Kyaa-A/oxyfeeder/app/assets/OxyFeeder.png

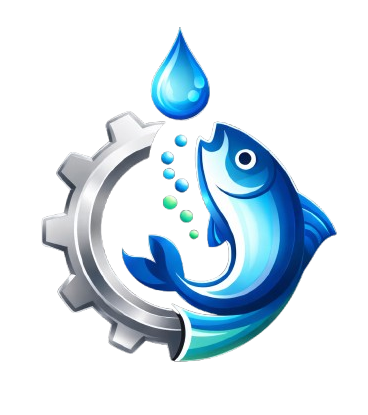
app/assets/OxyFeeder.png
