Kyaa-A/oxyfeeder/docs/session-log-jan24.md

# Development Session Log - January 24, 2026

## Session Summary

**Date:** January 24, 2026  
**Time:** 3:27 PM - 5:34 PM  
**Focus:** Phase 5 - Final Firmware Integration

---

## ✅ What Was Accomplished Today

### 1. Codebase Scan Complete
- Scanned entire project structure
- Reviewed all Flutter app code, firmware, and documentation
- Confirmed project is at ~95% completion

### 2. Phase 5 Firmware Written
- Created complete production firmware for Arduino Mega
- **File:** `firmware/oxyfeeder_firmware/oxyfeeder_firmware.ino` (787 lines)
- Features implemented:
  - Real sensor reading (DO sensor, voltage sensor, load cell)
  - RTC-based feeding schedule (08:00 and 17:00)
  - TFT LCD display with live data
  - Motor and servo control for feeding
  - Buzzer alarm for alerts
  - SMS alerts via SIM800L for critical low oxygen
  - JSON output to ESP32 via Serial1

### 3. ESP32 Firmware Uploaded Successfully ✅
- Uploaded `esp32_communicator.ino` to ESP32
- Verified ESP32 is advertising as "OxyFeeder" via BLE
- Confirmed working using nRF Connect app on phone

### 4. Configuration Updated
- Phone number for SMS alerts: `+639550717546`
- Feeding times: 08:00 and 17:00
- DO critical threshold: 4.0 mg/L

### 5. Cleaned Up Duplicate Files
- Moved `oxyfeeder_firmware_FINAL.ino` to backup (was causing compilation conflict)
- Moved `esp32_communicator_FINAL.ino` to backup

---

## ⏳ Blocked - Arduino Mega Driver Issue

### Problem:
- Arduino Mega not detected by PC
- Port shows "COM3 (not connected)"
- Cannot upload firmware to Arduino Mega

### Diagnosis:
- USB data cable works (confirmed with ESP32)
- Issue is likely:
  1. Arduino Mega uses CH340 chip (clone board) - needs driver
  2. OR Arduino Mega's USB port has hardware issue

### Solution Needed:
1. **Install CH340 driver:** https://sparks.gogo.co.nz/ch340.html
2. **OR** try different USB-B cable specifically for Arduino
3. **OR** test with a different Arduino Mega board

---

## 📋 Resume Checklist (Next Session)

When continuing, follow these steps:

```
[ ] 1. Fix Arduino Mega connection:
      - Install CH340 driver, OR
      - Try USB-B cable that works with other devices

[ ] 2. Upload firmware to Arduino Mega:
      - Open: firmware/oxyfeeder_firmware/oxyfeeder_firmware.ino
      - Board: Arduino Mega or Mega 2560
      - Port: (select detected COM port)
      - Click Upload

[ ] 3. Verify Arduino is working:
      - Open Serial Monitor (9600 baud)
      - Should see sensor readings and system status

[ ] 4. Connect Arduino to ESP32:
      - Arduino TX1 (pin 18) → Logic Shifter → ESP32 RX2 (pin 16)
      - Arduino RX1 (pin 19) → Logic Shifter → ESP32 TX2 (pin 17)
      - Power ESP32 from Arduino 5V

[ ] 5. Test end-to-end with phone:
      - Use nRF Connect to see real sensor data in JSON
      - OR run Flutter app on Android phone

[ ] 6. Phase 6: Field deployment and calibration
```

---

## 📁 Key File Locations

| File | Purpose |
|---|---|
| `firmware/oxyfeeder_firmware/oxyfeeder_firmware.ino` | Arduino Mega firmware (READY) |
| `firmware/esp32_communicator/esp32_communicator.ino` | ESP32 BLE bridge (UPLOADED ✅) |
| `app/lib/main.dart` | Flutter app entry point |
| `app/lib/core/services/real_bluetooth_service.dart` | Real BLE connection code |
| `docs/roadmap.md` | Project phases overview |

---

## 📊 Overall Project Status

| Phase | Description | Status |
|---|---|---|
| Phase 1 | Mobile App | ✅ Complete |
| Phase 2 | Communication Hub | ✅ Complete |
| Phase 3 | App Integration | ✅ Complete |
| Phase 4 | Hardware Assembly | ✅ Complete |
| Phase 5 | Final Firmware | 🔄 90% (Arduino upload pending) |
| Phase 6 | Deployment | ⏳ Next |

---

## 💡 Notes

- The Flutter app is currently set to **Mock Mode** for testing without hardware
- To switch to real hardware mode, edit `app/lib/main.dart` and swap the service providers
- ESP32 is ready and waiting for Arduino data
- All sensors and actuators are wired and ready

---

## 🆕 Late Addition: SMS Configuration Feature (5:50 PM)

### Feature Implemented
Added ability to configure SMS phone number from the app instead of hardcoding in firmware.

### Changes Made:

**1. Arduino Firmware (`oxyfeeder_firmware.ino`):**
- Added EEPROM library for persistent storage
- Phone number stored in EEPROM (survives power off)
- Added command processing from ESP32:
  - `PHONE:+639XXXXXXXXX` - Set phone number
  - `FEED:5` - Trigger manual feeding
  - `TEST_SMS:1` - Send test SMS
  - `GET_PHONE:1` - Get current phone number
- Default phone number: `+639550717546`

**2. ESP32 Firmware (`esp32_communicator.ino`):**
- Added WRITE characteristic for receiving commands from app
- New Command Characteristic UUID: `0000abcf-0000-1000-8000-00805f9b34fb`
- Commands from app are forwarded to Arduino via Serial2

**3. Flutter App (`real_bluetooth_service.dart`):**
- Added command characteristic discovery
- New methods:
  - `sendCommand(String command)` - Send raw command
  - `setPhoneNumber(String phone)` - Set SMS phone number
  - `triggerManualFeed()` - Trigger feeding
  - `sendTestSms()` - Send test SMS

**4. Settings Screen (`settings_screen.dart`):**
- Added "SMS Alert Configuration" section
- Phone number input field
- "Save to Device" button
- "Test SMS" button

**5. Settings ViewModel (`settings_viewmodel.dart`):**
- Added `smsPhoneNumber` property
- Added methods for sending commands via Bluetooth

### Data Flow for Commands:
```
App (Settings) → BLE Write → ESP32 → Serial2 → Arduino → EEPROM (save)
```

---

## ⚠️ ESP32 Needs Re-upload!

Since we updated the ESP32 firmware with the new command characteristic, you need to re-upload it when the Arduino driver is fixed.

---

**Next session focus:** Fix Arduino driver, re-upload ESP32, upload Arduino firmware, test full system!
