Kyaa-A/oxyfeeder/docs/create-prd.md

# Product Requirements Document: OxyFeeder

**Version:** 1.0  
**Date:** October 26, 2025  
**Author:** AI Product Manager  

---

## 1. Overview

OxyFeeder is an IoT-based, solar-powered aquaculture management system designed to automate critical fishpond operations. It provides automated, scheduled fish feeding and continuous, real-time monitoring of dissolved oxygen (DO) levels. The system is engineered for sustainability and resilience, making it ideal for small to medium-scale fish farms, particularly in remote or off-grid locations. By leveraging solar power and IoT connectivity, OxyFeeder aims to reduce manual labor, optimize feed usage, prevent fish kills from hypoxia, and promote data-driven, sustainable aquaculture.

---

## 2. Problem Statement

Traditional aquaculture practices are labor-intensive and prone to inefficiencies that impact profitability and sustainability. Key challenges include:

- **Manual Labor:** Daily manual feeding is time-consuming and inconsistent, leading to scheduling errors.  
- **Feed Waste:** Overfeeding wastes costly resources and contributes to water quality degradation. Underfeeding stunts fish growth.  
- **Hypoxia Risk:** Sudden drops in dissolved oxygen are a primary cause of mass fish kills. Manual spot-checks are often insufficient.  
- **Energy Costs:** Grid-powered systems are expensive and impractical for off-grid farms.  

OxyFeeder directly addresses these issues by providing an automated, self-powered, and intelligent monitoring solution.

---

## 3. Objectives

- Automate Core Operations  
- Enhance Water Quality Monitoring  
- Improve Resource Efficiency  
- Increase Accessibility  

---

## 4. Key Features

- Automated feeding based on schedule  
- Real-time DO monitoring  
- Multi-level alert system (App & SMS)  
- Solar-powered operation  
- OLED display for status  
- Optional ESP32-CAM camera monitoring  

---

## 5. Hardware & Software Components

**Hardware:** Arduino Mega 2560, ESP32, Solar System (Panel, MPPT, Battery), DC Gear Motor, DO Sensor, Load Cell, RTC, OLED, GSM, ESP32-CAM.  
**Software:** Custom Arduino/ESP32 firmware + Flutter mobile app.

---

## 6. User Stories

- As a fish farmer, I want to schedule feedings remotely.  
- As a fish farmer, I want alerts when DO or feed levels are low.  
- As a fish farmer, I want solar-powered autonomy for remote use.  
- As a fish farmer, I want to see feed level status in the app.  

---

## 7. Requirements

### Functional
- Automated feed dispensing on schedule  
- DO reading every 15 mins  
- Alerts for low DO, feed, or battery  
- App display for live data  

### Non-Functional
- 99% uptime  
- IP67 enclosure  
- 48h solar autonomy  
- Easy setup  
- Secure communication  

---

## 8. Success Metrics

- System uptime  
- Alert accuracy  
- Feed and power efficiency  
- User adoption rate  

---

## 9. Risks & Mitigation

| Risk | Likelihood | Impact | Mitigation |
|---|---|---|---|
| Hardware failure | Medium | High | Use waterproof, modular parts |
| Network loss | High | Medium | Fallback to GSM + local logging |
| Power failure | Low | High | MPPT + low-voltage cutoff |
| Sensor drift | Medium | Medium | Regular calibration schedule |

---

## 10. Future Enhancements

- Cloud dashboard for analytics  
- Add pH & temperature sensors  
- AI-based feeding prediction  
- Automatic aerator control
