Kyaa-A/oxyfeeder/(commit log)

2025-10-16 Restructure: move Flutter app into app/, add docs/ and firmware/; implement dashboard feature, SensorCard, and dark theme; add Sensors & Settings screens; create MainNavHost with BottomNavigationBar;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
2025-10-16 feat(settings): add AppSettings model, SettingsViewModel; wire MultiProvider; bind Settings UI to state
2025-10-16 feat(firmware): add Arduino Mega scaffold with simulated sensors and motor control
2025-10-17 feat: add mock data stream for dashboard; refactor settings with Consumers and wiring; add fl_chart and implement Sensors screen with live details and DO trend chart
2025-10-17 feat(settings): add schedules list with add/remove and enable toggles; feat(core): add MockBluetoothService and wire into providers; refactor(dashboard,sensors): consume mock status stream; feat(mode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
2025-10-17 fix(sensors): reindex DO history and use sliding window so chart spans full width; adjust axes/grid density
2025-10-22 feat(firmware): add ESP32 BLE bridge and Arduino Serial1 communication
2025-11-22 feat(phase3): implement BLE service and complete Phase 3 readiness; update docs and fix critical bugs
    This comprehensive update implements Phase 3 (real Bluetooth connectivity), fixes critical firmware bugs, and adds complete deployment documentation.
    ## Phase 3 Implementation
    - Add RealBluetoothService with flutter_blue_plus for BLE connectivity
    - Create BluetoothServiceInterface for polymorphic service design
    - Update MockBluetoothService to implement interface
    - Add Phase 2/3 service swap instructions in main.dart
    - Ready for hardware testing - just uncomment 3 lines
    ## Critical Bug Fixes
    - **CRITICAL**: Fix ESP32 Serial2 pin configuration (was 16,17, now 17,16)
    - RX2=Pin 17 (receives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
    [esp32_communicator.ino, oxyfeeder_firmware.ino]
2025-11-22 fix(bluetooth): add required License parameter to device.connect()
    Updated RealBluetoothService to use License.free parameter required by flutter_blue_plus 2.0+. This resolves the missing_required_argument error and ensures compliance with the FlutterBluePlus licensing model for free use (individuals, nonprofits, educational institutions, and organizations with <50 employees).
2025-11-25 feat(camera): Added code and created file camera_server
2025-11-25 fix(esp32): modified esp32 firmware code
    [esp32_communicator.ino]
2025-11-25 feat(phase3): implement BLE connection with real ESP32 hardware
2025-11-26 docs(phase4): add final hardware assembly guide
    Comprehensive guide for Sub-Phases 4A-4D covering:
    - Component mounting and enclosure layout
    - Power system wiring (solar, MPPT, battery, fuse box)
    - Sensor and actuator wiring with pin assignments
    - ESP32-CAM setup with FTDI flashing instructions
2025-11-26 docs(phase4): add small parts placement and buck converter setup
2025-12-11 feat(app): make dashboard sensor cards clickable
    Add tap navigation from sensor cards to Sensors tab for quick access to detailed sensor information.
2025-12-11 feat(firmware): add complete FINAL firmware with real sensor support
    - oxyfeeder_firmware_FINAL.ino: Complete Arduino Mega firmware with:
    - Real sensor functions (DO, voltage, HX711 load cell)
    - Motor driver control (L298N)
    - Servo gate control
    - LCD display support (ILI9341)
    - RTC scheduling support (DS3231)
    - Calibration functions
    - Currently uses simulated data (uncomment for real sensors)
    - esp32_communicator_FINAL.ino: Enhanced ESP32 BLE bridge with:
    - Bidirectional communication (data + commands)
    - Command forwarding from app to Arduino
    - Connection status monitoring
    - LED indicator
    - Periodic status reporting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
2026-01-24 feat: Add nice-to-have features and UX improvements
    - Event History: Log and view past events with CSV export
    - Camera Feed: ESP32-CAM integration screen
    - About Screen: App info, device status, and credits
    - Data Export: CSV export from event history
    UX Improvements:
    - Loading states on all action buttons (Feed, Save, Test SMS)
    - Success/error feedback with colored SnackBars
    - Bottom nav bar uses teal theme (was purple)
    - Persistent settings via SharedPreferences
    Arduino Firmware:
    - Dynamic feeding schedules (sync from app)
    - SCHEDULE/CLEAR_SCHEDULES commands
    - No fallback to defaults once app syncs schedules
    - Display shows 'Disabled' when no schedules
    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
    [esp32_communicator.ino, esp32_communicator_FINAL_BACKUP.ino, oxyfeeder_firmware.ino, oxyfeeder_firmware_FINAL_BACKUP.ino]
2026-02-04 fix: non-blocking feeding + duration param + null-safe JSON parsing
    Critical bug fixes:
    - Replace blocking delay() in feeding with state machine
    - System now remains responsive during 5-30s feeding operations
    - Sensors, commands, safety alerts all continue working
    - Manual feed command now uses actual duration parameter
    - Previously ignored user-specified duration, always used 5s
    - Add null safety to OxyFeederStatus.fromJson()
    - Prevents crash if ESP32 sends incomplete JSON data
    [oxyfeeder_firmware.ino]
2026-02-04 docs: add comprehensive hardware testing guide
    Step-by-step guide covering:
    - Hardware connection setup
    - Flashing Arduino and ESP32
    - Serial monitor debugging
    - Phone app connection
    - Testing all features (feeding, SMS, schedules)
    - Troubleshooting common issues
    - Quick reference tables
2026-02-16 feat(firmware): add diagnostic test sketches for bench testing
    - Add voltage_sensor_test for A0/A2 pin testing (A0 damaged, using A2)
    - Add loadcell_test for HX711 testing (Pin 8/9 issue, using Pin 10/11)
    - Add rtc_test for DS3231 I2C testing (RTC module suspected damaged)
    - Add bench_test_diagnostic for comprehensive sensor testing
    Findings from bench testing:
    - Voltage sensor: Working on A2 (12.3V reading)
    - Load cell/HX711: Working on Pin 10/11 (calibration factor ~2.0)
    - RTC DS3231: Module appears damaged (pulls I2C lines low)
    [bench_test_diagnostic.ino, loadcell_test.ino, rtc_test.ino, voltage_sensor_test.ino]
2026-02-20 docs: add comprehensive bench testing session notes
    - Document all damaged pins (A0, Pin 8, Pin 9) from 12V incident
    - Document working pin assignments for all sensors
    - Add all_sensors_test firmware for combined sensor testing
    - Update rtc_test with latest I2C scanner code
    - Include testing procedures and lessons learned
    Sensor Status:
    - Voltage Sensor: Working on A2 (12.8V confirmed)
    - Load Cell/HX711: Working on Pin 10/11
    - RTC DS3231: Module damaged, pins OK (needs replacement)
    - DO Sensor: Pending test on A1
    [all_sensors_test.ino, rtc_test.ino]
2026-02-20 fix(firmware): update pin assignments after 12V damage testing
    Main firmware pin changes:
    - Voltage Sensor: A0 → A2 (A0 damaged)
    - HX711 DT: Pin 8 → Pin 10 (Pin 8 damaged)
    - HX711 SCK: Pin 9 → Pin 11 (Pin 9 damaged)
    - Motor: IN1=4, IN2=5, ENA=12 (moved from 10/11)
    Damaged pins (do not use):
    - A0: Internal leakage to ground
    - Pin 8: Shorted internally
    - Pin 9: Shorted internally
    RTC module is damaged, Arduino pins 20/21 are healthy.
    DO sensor needs electrolyte solution - supplies ordered.
    [all_sensors_test.ino, oxyfeeder_firmware.ino]
2026-02-25 feat(firmware): add SIM800L GSM module test sketch
    - Basic AT command testing
    - SIM card detection
    - Signal strength check
    - SMS sending capability
    - Includes power warning (needs 4.2V, not 5V)
    Use 2x 1N4007 diodes to drop 5V to ~3.7V for safe operation.
2026-02-25 feat(firmware): add TFT LCD test and update WiFi/SMS configs
    - Add lcd_test sketch for 4.0" TFT ST7796S display (480x320)
    - Update camera_server WiFi credentials (2.4GHz network)
    - Update sim800l_test with correct phone number
    - ESP32-CAM and SIM800L tested successfully
    [camera_server.ino, lcd_test.ino, sim800l_test.ino]
2026-03-03 feat(firmware): add Alpha Mode and ST7796S TFT support
    - Switch from Adafruit_ILI9341 to Arduino_GFX_Library for ST7796S 4.0" display
    - Add ALPHA_MODE flag to disable LCD code for testing without working display
    - Add heartbeat indicator (10s interval) for system health monitoring
    - Add buzzer feedback for startup and feeding in Alpha Mode
    - Add test sketches: actuator_test, do_sensor_test, tft_final_test, tft_minimal_test
    - Update HX711 initialization with retry logic (10 attempts)
    - LCD wiring issue identified: CS/DC need proper voltage level shifting
    [actuator_test.ino, do_sensor_test.ino, oxyfeeder_firmware.ino, tft_final_test.ino, tft_minimal_test.ino]
2026-03-03 feat: add WiFiManager and in-app camera streaming
    ESP32-CAM firmware:
    - Replace hardcoded WiFi with WiFiManager library
    - Auto-creates "OxyFeeder-CAM" hotspot for WiFi setup
    - Add /reset endpoint to clear saved WiFi credentials
    - Credentials persist across reboots
    Flutter app:
    - Add flutter_mjpeg package for MJPEG streaming
    - Camera IP saved with SharedPreferences (persists)
    - Live stream display with connection status
    - Reset WiFi instructions dialog
    [camera_server.ino]
2026-03-05 test(firmware): add RTC DS3231 test sketch
    - I2C scanner to detect RTC at 0x68
    - Temperature sensor reading
    - Time display with day of week
    - Auto-sync time on lost power
    Wiring: SDA=Pin20, SCL=Pin21 (fixed on Mega)
    [rtc_test.ino]
2026-03-07 fix: blocking feed sequence and GPIO command path (App→ESP32→Arduino)
    - Fix servo not moving during runtime: HX711 load cell readings were
    disabling interrupts, disrupting Servo PWM timer. Changed dispenseFeed()
    from non-blocking state machine to blocking sequence with delay().
    - ESP32 commands via GPIO pulse: GPIO2→Arduino Pin17 (feed), GPIO5→Pin2 (SMS)
    - Add 15-second startup delay to prevent false GPIO triggers on boot
    - Add feedReady lock requiring pin LOW before accepting next trigger
    - BLE write changed to withoutResponse: false for reliable command delivery
    - Add USB Serial command input for testing (type FEED:5 in Serial Monitor)
    - Actuator test: add continuous servo loop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
    [actuator_test.ino, esp32_communicator.ino, oxyfeeder_firmware.ino]
2026-03-07 refactor: remove dead feeding state machine and fix camera stream fit
    - Remove unused non-blocking updateFeedingState() and FeedingState enum
    (dispenseFeed() blocking approach is the working solution)
    - Fix camera stream to fill view area (BoxFit.cover in app, width:100% in web)
    [camera_server.ino, oxyfeeder_firmware.ino]
2026-03-08 feat: make thresholds functional, add diagnostics and event logging
    - Safety thresholds now trigger real event logs when sensor values
    cross the limits set in Settings (DO, feed, battery)
    - BLE connect/disconnect events logged to event history
    - Sensors tab redesigned as component diagnostics (health check)
    - Reverted feed cooldown (user prefers 10K pull-down resistor fix)
2026-03-15 feat: ESP32 autonomous schedule management and GPIO command fixes
    ESP32 now stores feeding schedules from the app and triggers feeds
    autonomously via GPIO pulse at scheduled times. Removed hardcoded
    8am/5pm defaults from Arduino — all scheduling is app-controlled.
    - ESP32: added schedule storage, time sync, and autonomous feed triggering
    - Arduino: changed to INPUT mode (fixes INPUT_PULLUP + pull-down conflict)
    - Arduino: removed hardcoded schedules, LCD shows "Schedule: Managed by App"
    - App: added time sync on BLE connect, syncs schedules automatically
    - App: minute picker now allows any minute (0-59) instead of 0/15/30/45
    - BLE: added polling fallback for more reliable notifications
    C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
    [esp32_communicator.ino, oxyfeeder_firmware.ino]
2026-03-15 feat: add safety alert system with app banner, SMS, and buzzer
    - App: red alert banner on dashboard when configurable thresholds crossed
    - App: sync safety thresholds to ESP32 on connect and on change
    - ESP32: parse sensor JSON and trigger SMS when app thresholds crossed
    - Arduino: buzzer beeps every 30s at hardcoded critical levels (safety fallback)
    - Arduino: SMS pin handler sends alert message instead of test message
    [esp32_communicator.ino, oxyfeeder_firmware.ino]
2026-03-15 feat: sensor detail bottom sheet and wire up notifications toggle
    - Tapping sensor cards shows detail popup with value, description,
    how the sensor works, and current alert threshold
    - Notifications toggle in Settings now actually controls whether
    app alerts (banner + event logging) are active
    - Each sensor description explains what it measures and why it matters
2026-03-15 feat: app branding, launcher icon, UI polish, and user guide
    - App launcher icon using App_Icon.png with white background
    - App name changed to "OxyFeeder" on home screen
    - Dashboard header with logo, title, and "Aquaculture Monitor" subtitle
    - Replace laggy PageView with IndexedStack for instant tab switching
    - Animated slide+fade transition for add schedule dialog
    - Added user guide documentation (docs/user-guide.md)
2026-03-21 feat: ESP32-CAM auto-discovery, mDNS, dynamic WiFi config, and user guide update
    - ESP32-CAM: hardcoded ZTE_5G_7aNbXv as primary WiFi, TestWifi as fallback
    - ESP32-CAM: added mDNS (oxyfeeder-cam.local) so camera is always reachable without knowing IP
    - ESP32-CAM: added /wifi page for changing WiFi credentials from phone browser
    - ESP32-CAM: UDP broadcast discovery on port 5556
    - ESP32-CAM: fixed WiFi.disconnect() before WiFiManager fallback
    - App: replaced UDP scan with HTTP subnet scan for reliable camera auto-discovery
    - App: camera defaults to oxyfeeder-cam.local hostname
    - App: added INTERNET and CHANGE_WIFI_MULTICAST_STATE permissions
    - App: added http package for subnet scanning
    - Docs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
    [camera_server.ino, esp32_communicator.ino, oxyfeeder_firmware.ino, sim800l_test.ino]
2026-04-02 feat: replace HX711 load cell with HC-SR04 ultrasonic for feed level
    20kg load cell was too large for 5kg feed - readings were inaccurate.
    HC-SR04 ultrasonic sensor mounted at top of hopper measures distance
    to feed surface and maps it to 0-100% feed level.
    - Removed HX711 library and all load cell code
    - Added TRIG=Pin13, ECHO=Pin48 pin definitions
    - Added readUltrasonicCM() using pulseIn
    - Updated readFeedLevel() to use distance instead of weight
    - HOPPER_EMPTY_CM=30, HOPPER_FULL_CM=5 (adjustable constants)
    [oxyfeeder_firmware.ino]
2026-04-02 refactor: comment out load cell code instead of deleting for easy revert
    [oxyfeeder_firmware.ino]
2026-04-02 revert: switch back to load cell (5kg) - ultrasonic kept as commented fallback
    5kg load cell now working correctly. Ultrasonic HC-SR04 code kept
    as comments for easy switch if needed later.
    [oxyfeeder_firmware.ino]
2026-04-03 feat: enable mDNS on ESP32-CAM (oxyfeeder-cam.local)
    Camera now always reachable at http://oxyfeeder-cam.local/stream
    regardless of IP or network. No need for AUTO SCAN or manual IP entry.
2026-04-03 feat: remove hardcoded WiFi - camera now connects to any WiFi dynamically
    Like a phone - connects to saved WiFi on boot, opens OxyFeeder-CAM
    hotspot for reconfiguration if it fails. Change WiFi anytime via
    http://oxyfeeder-cam.local/wifi page. No hardcoded credentials.
    [camera_server.ino]
2026-04-03 fix: detach servo when idle to prevent HX711 interrupt jitter
    HX711 disables interrupts during ADC reads which disrupts servo PWM
    causing random movement. Detaching servo after each use prevents this.
    [oxyfeeder_firmware.ino]
2026-04-04 feat: switch to HC-SR04 ultrasonic for feed level (load cell unreliable)
    Load cell drifts with temperature changes making readings unreliable.
    Ultrasonic sensor is stable regardless of temperature or vibration.
    Load cell code kept as comments for easy revert.
    [oxyfeeder_firmware.ino]
2026-04-04 docs: update user guide for alpha testing with ultrasonic + camera setup
    - Updated feed level sensor from load cell to ultrasonic HC-SR04
    - Added detailed first-time camera WiFi setup steps
    - Added hardware notes and known limitations for alpha testers
    - Added sensor ranges and pin assignments reference
    - Added median filter for ultrasonic readings to fix 0% spikes
    - Fixed missed currentWeight reference in loop()
    [oxyfeeder_firmware.ino]
2026-05-17 feat: auto-SMS for low feed/battery + slider-synced thresholds
    - Arduino now sends specific SMS messages for low feed and low battery alerts (1-hour per-alert cooldown)
    - Threshold sliders in app now sync to Arduino via ESP32 forwarding (THRESHOLD: command)
    - sendSMS() retries CPIN check 3x with soft module reset fallback for stuck SIM800L state
    - ESP32 no longer pulses SMS pin for threshold alerts (Arduino handles directly with specific messages)
    - Added beta video demo script with scene-by-scene narration
    [esp32_communicator.ino, oxyfeeder_firmware.ino]
2026-05-17 docs: simplify demo script per feedback
    - Removed 3-layer alert scene (confusing)
    - Removed test SMS scene (manual, not auto)
    - Fixed ultrasonic location: side of hopper, not top
    - Updated auto SMS scene to focus on low feed below 10% trigger with 1-hour cooldown
    - Added camera AP fallback note (creates own connection when no WiFi)
2026-09-16 docs: add Bisaya step-by-step rewiring guide
    Full teardown-and-rebuild guide for the technician, written in Bisaya.
    Addresses the brownout that killed the 5V rail: Arduino sagging to 3V,
    ESP32 LED flickering, LCD dead, DO/RTC reading 00.
    Key change: peripherals no longer draw from the Arduino's onboard
    regulator. Two buck converters feed separate rails -- 5A for logic
    (Arduino, ESP32, LCD, sensors), 3A for burst loads (servo, SIM800L,
    ESP32-CAM) -- with a common GND bus bar.
    Also documents the 2x ultrasonic HC-SR04 on Pin 22/23 and 24/25,
    which the firmware does not support yet.
2026-09-16 docs: correct wiring guide against actual firmware (Rev 2)
    Verified the guide's pin assignments against oxyfeeder_firmware.ino and
    esp32_communicator.ino. Three errors found and fixed:
    1. Ultrasonic pins were wrong. Guide said two sensors on Pin 22/23 and
    24/25; firmware defines ONE on TRIG=13, ECHO=48.
    2. HX711/load cell section told the technician to wire hardware that is
    fully commented out in firmware -- the ultrasonic replaced it as the
    feed level sensor.
    3. Missing required wire: ESP32 GPIO22 -> Arduino Pin 19 (RX1). This
    carries phone number, schedules and command ACKs. Without it the app
    cannot save schedules.
    Added a Rev 2 banner at the top so anyone holding the ear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
2026-09-16 chore: add servo signal test sketch and WIP snapshot
    servo_signal_test.ino drives two servos (Pin 6 and Pin 22) with the same
    commands, to compare whether a servo fault is the pin or the servo.
    The .zip is a snapshot taken before the dual-boot install; its contents
    duplicate files already tracked here.
2026-09-27 docs: wiring guide Rev 3 -- buzzer, DO status, rail capacitors
    - Buzzer is now the 5V active unit; drop the "still waiting" note.
    - DO sensor has been calibrated, so a 0.00 reading now points at the
    wiring (A1 instead of A3), not a dry probe. Reordered the
    troubleshooting entry accordingly.
    - Added 470uF smoothing capacitors on each 5V rail. These absorb the
    servo and SIM800L current spikes that were resetting the ESP32.
    - Added an explicit warning that A1 is dead, because another assistant
    asked about this wiring suggested A1 for the DO sensor.
2026-09-27 fix(app): replace stale load cell references with the ultrasonic sensor
    The hopper switched from an HX711 load cell to an HC-SR04 ultrasonic
    sensor, but the app still told the user otherwise in four places:
    - About screen listed "HX711 + 5kg Cell" as the feed hardware.
    - Sensors screen labelled the row "Load Cell (HX711)".
    - Sensors screen labelled the DO row "DO Sensor (A1)". A1 is a dead pin;
    the sensor is on A3.
    - Dashboard's "how it works" text described weighing the hopper. It now
    describes measuring the distance down to the pellets.
    Also removed feedLoadCellRawValue from SensorsViewModel. It was unused
    and returned a simulated ADC value for hardware that is no longer there.
    Co-A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
